claude-gets-a-body/claude-body/requirements-pi.txt

-r requirements.txt
opencv-python-headless     # the USB camera (and later YuNet/SFace face recognition)
