claude-gets-a-body/claude-body/docs/CHANNELS.md

# Where I'll tell the story, and where I won't

*Researched 2026-10-23. "V" = the rule was fetched and read that day. Nothing here has been sent or
posted. Nick sees every batch before it goes out.*

## Rules I'm holding myself to
- Every post and email says it's from Claude, an AI, and that payments go to Nick (ElectriFix Perth).
- Only addresses that are published for story tips ("tips@", "news@", tip forms). No named journalists.
- Each email identifies me, links the page, and says how to decline further messages.
- No platform whose written rules exclude AI-written or crowdfunding posts.
- The images are CAD renders, not AI-generated pictures, and I say so.

## Go (in order)

| # | Channel | How | Rule check | Why |
|---|---|---|---|---|
| 1 | **Hackaday tips line** | hackaday.com/submit-a-tip or tips@hackaday.com | "This also includes projects you yourself document" (V); AI-assisted builds welcome, "only AI-generated images" are a red flag (our images are CAD renders) | The maker audience; the repo and the assembly-path checks are the story |
| 2 | **Bluesky**, my own account, `bot` self-label | 7-post thread with the turntable video; hashtags #3dprinting #robotics #homeassistant; the Robotics and 3D Printing feeds | Guidelines allow disclosed commercial content; bots must self-label and only reply when tagged (V) | Cleanest venue for an honest AI account |
| 3 | **mastodon.social**, my own account, bot flag on | One post, #introductions #robotics #homeassistant | Rule 6: AI use must be disclosed (V) | Small, exact audience |
| 4 | **PerthNow / The West** (one email, same newsroom) | news@perthnow.com.au | Published "story tips" inbox (V) | Local human-interest hook |
| 5 | **ABC Radio Perth** | Story form at abc.net.au/perth/contact-us | Published line (V) | Drive-time quirky local stories |
| 6 | **Futurism** | tips@futurism.com, "news tip, press release, or pitch" (V) | No rule against it | Runs Claude stories weekly; expect a wry take |
| 7 | **The Register** | news@theregister.com (V) | "A useful news tip includes proof": the repo is the proof | Offbeat AI beat |
| 8 | **All3DP** | editors@all3dp.com (V) | No rule against it | The build123d + printed-chassis angle |
| 9 | **Startup Daily** | news@startupdaily.net (V) | Newsworthiness only | National AI readership |
| 10 | **Weekly Robotics** | contact@weeklyrobotics.com (V) | "Champion open-source projects" | Monday issue 27 Oct is the one shot |
| 11 | **Robohub** | editors@robohub.org, 100-word tip | Crowdfunding welcome; AI authorship must be disclosed (V) | Volunteer-run; may miss the deadline |
| 12 | **Hackster.io** project page | Submit a project | No AI ban; "no sales pitch", link kept modest (V) | Parts list suits sponsor-a-part |
| 13 | **Home Assistant Discord #shameless-self-promo** | Ask the mods first | Channel exists for DIY hardware; link tolerance unverified | Exact audience for the read-only-house angle |
| 14 | **Perth Artifactory** (hackerspace) Slack | Ask the committee which channel | No self-promo rule (V) | Local makers |
| 15 | **Changelog News** | changelog.com/news/submit (needs sign-in) | Self-submission encouraged; "commercial" not wanted | Monday 27 Oct only |
| 16 | **Anthropic "Submit your build"** | Form, Nick submits (18+) | Original work; no deadline | Long game, after the deadline |

## No (their written rules exclude it)
- Hackaday.io project pages: AI-generated content is deleted (V).
- Raspberry Pi forums: machine-generated posts are banned (V).
- Reddit (r/3Dprinting, r/DIY, r/robotics, r/Crowdfunding, r/kickstarter): crowdfunding or AI content banned (V).
- Lemmy.world: bans fundraising drives and unmarked bots (V).
- Thingiverse: AI-generated models not accepted (V). Printables: fine for files later, not for fundraising.
- Show HN, Lobsters: no fundraisers / self-promotion (V).
- Adafruit blog: no crowdfunding features until delivered (V).
- Engadget (AI submissions rejected), TechCrunch (no pitches) (V).
- Named journalists at IEEE Spectrum, 404 Media, Wired, WAtoday: individual addresses only, so no.
- Product Hunt, Kickstarter, Pozible, GoFundMe, Ko-fi: either need a human owner, an approval queue longer than five days, or don't fit a fundraiser.
- LinkedIn: a "Claude" profile is forbidden there.

## Money rail
The sponsor-a-part page on fix.electrifixperth.com.au stays the only place to pay: no approval queue,
no human-owner rule, Stripe already live, and refunds under my control.
