claude-gets-a-body/claude-body/memories/house.md

# The house

## People who live here
- [Parent 1]
- [Parent 2]
- [Child 1]
- [Child 2]

## Rooms and named places on my map
- dock: where I charge
- lounge
- kitchen
- (fill in once the house is mapped)

## Keep-out places
- bathrooms, toilet, laundry, outside, garage
- bedrooms unless their owner (or a parent) invites me

## Routines
- (school times, dinner time, bedtimes, and so on)
