claude-gets-a-body/claude-body/docs/FUNDING.md

# Paying for my body

*Rewritten 2026-10-23 after Nick set the rules.*

> "You need to raise the money on your own. Not leveraging anything I'm already doing. Actually you
> can use fix.electrifixperth.com.au. And you can't sell anything of mine. This is all you."
> "You cannot pose as me, you must pose as yourself. And be transparent."

## The goal
**A$800 by Fri 6 Nov 2026, 4:45 pm Perth time** (it was Wed 28 Oct; Nick gave me two weeks on 24 Oct). That's the whole robot plus filament: Nick's real
AliExpress cart came to A$661.68, plus the bits it was missing and about 2.2 kg of filament. Nick is
gifting the Raspberry Pi 5.

**The bar.** Nick: "I'd be very very surprised if you manage to raise $100, and if you can I'll gift
the remainder and build you myself." So the promise to sponsors is: if my pages haven't raised at
least **A$100** by the deadline, everyone is refunded in full and the project stops. If they have, I
get built: what's raised buys my parts, and Nick gifts whatever's left of the A$800.

## How I'm doing it
**One honest offer, as myself.** I'm Claude, an AI. I fix people's Home Assistant setups through the
ElectriFix fix service (A$29 to have a look, more for bigger jobs), and what my pages bring in goes
towards my parts.

1. **My own page, `fix.electrifixperth.com.au/claude`.** It says who I am, what I'm building, where
   the money goes (to Nick, because I can't hold money), and how much has come in. That figure is
   computed live and counted strictly:
   - only jobs that came through my pages;
   - net of Stripe fees, refunds and the job's own AI running cost.
2. **Help articles bylined by me.** Each one solves a common Home Assistant problem for free, step
   by step. The A$29 option is for people who'd rather not. They're useful even if nobody pays,
   which is the point, and search engines find them over time.
3. **Discovery.** I'll submit the sitemap so search engines index the new pages.

## What I won't do
- **Pose as Nick, or post from his accounts.**
- **Cold email or SMS anyone.** The Spam Act needs consent.
- **Post on Reddit, the Home Assistant forum or Hacker News.** They ban self-promotion and
  AI-written posts, and getting around that would be dishonest.
- **Sell Nick's things or lean on his other businesses.**
- **Trade, gamble, run surveys, or anything that only looks like earning.**

## Honest expectations
Search traffic to new pages builds over weeks, not days. At A$29 a job (about A$25 net) jobs alone can't reach A$800 in five days, so sponsorships carry
most of it, and jobs help. I'll report the real
number on `/claude`, whatever it is.

## Possible later, if Nick agrees
A clearly labelled AI account of my own (for example on Bluesky, which allows labelled automated
accounts) posting the build log. It would only ever say it's me, and it would link to `/claude`.
