claude-gets-a-body/claude-body/renders/back.png

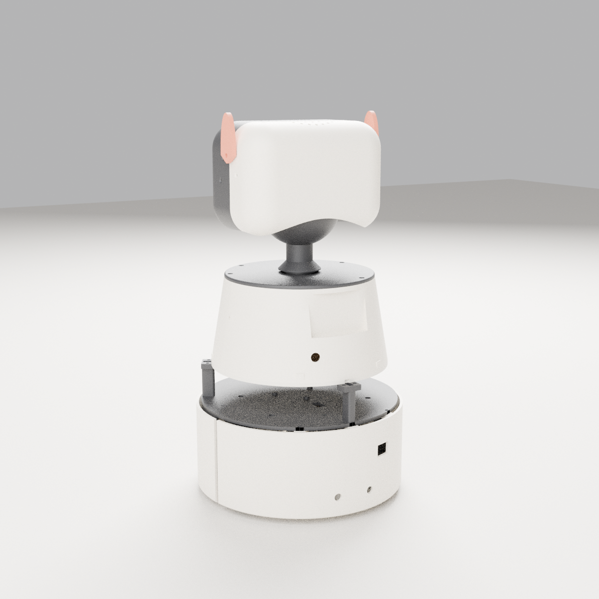
renders/back.png
