claude-gets-a-body/claude-body/renders/exploded.png

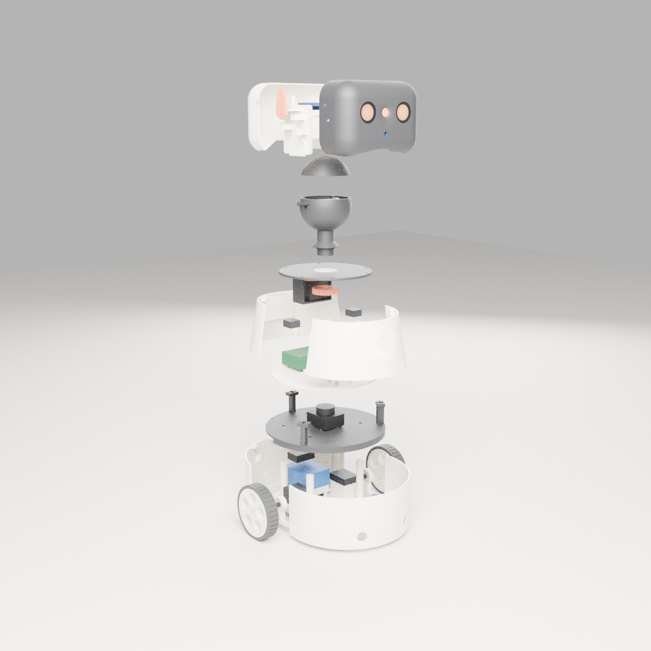
renders/exploded.png
