claude-gets-a-body/claude-body/renders/inside.png

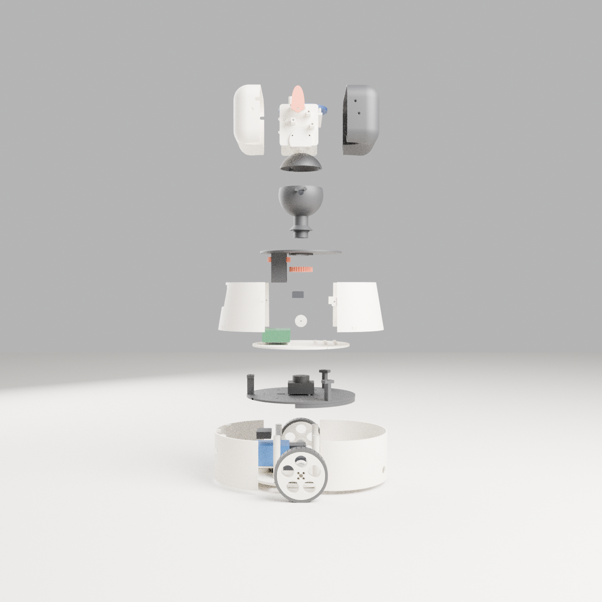
renders/inside.png
