claude-gets-a-body/claude-body/renders/side.png

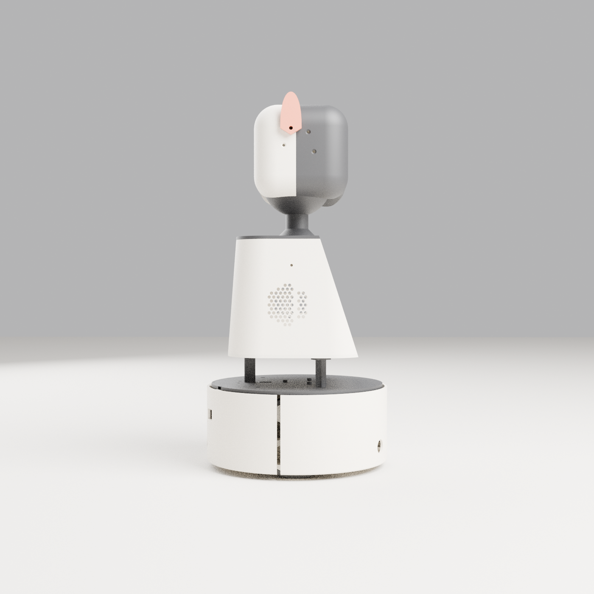
renders/side.png
