claude-gets-a-body/claude-body/sim_frames/dock.jpg

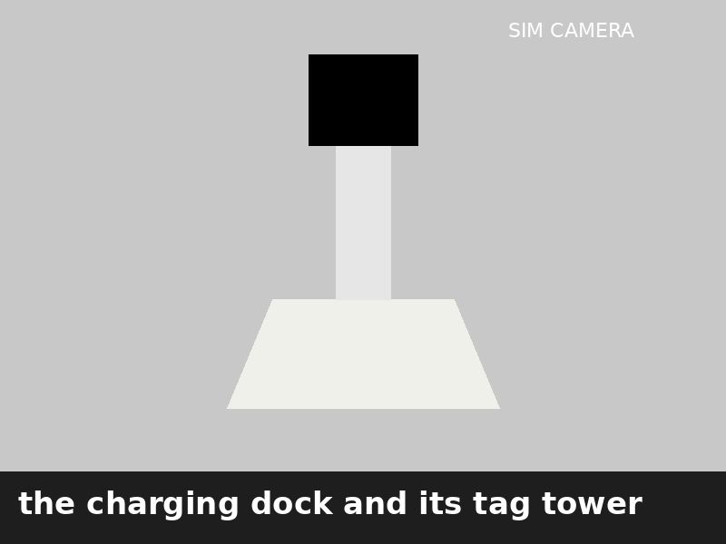
sim_frames/dock.jpg
