claude-gets-a-body/claude-body/sim_frames/homework.jpg

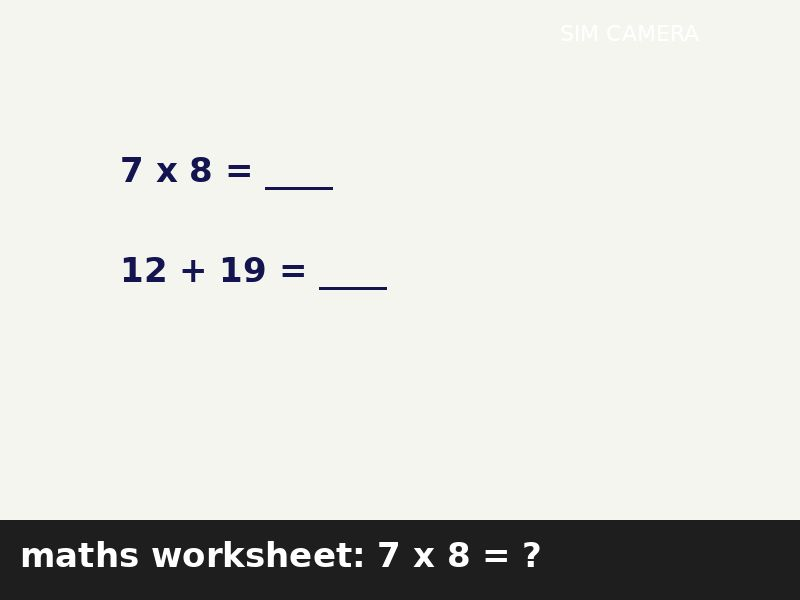
sim_frames/homework.jpg
