claude-gets-a-body/claude-body/sim_frames/kitchen.jpg

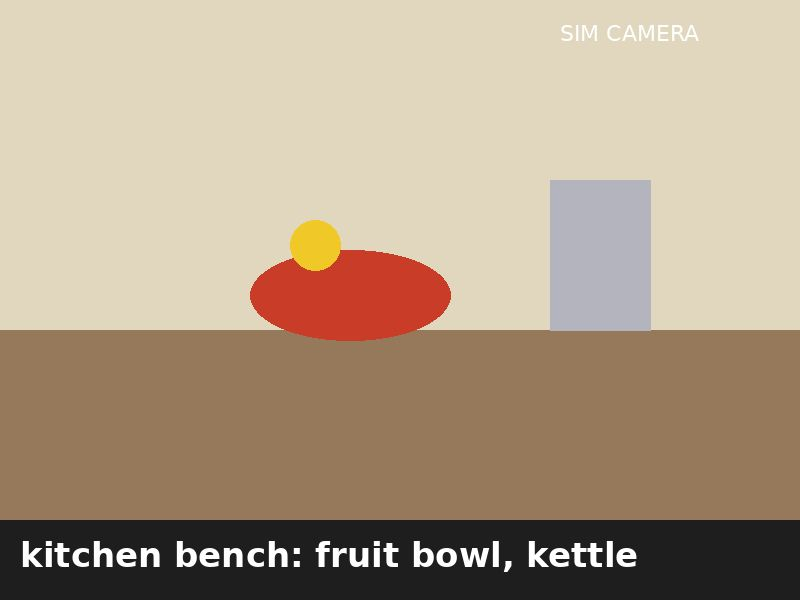
sim_frames/kitchen.jpg
