claude-gets-a-body/claude-body/sim_frames/lounge.jpg

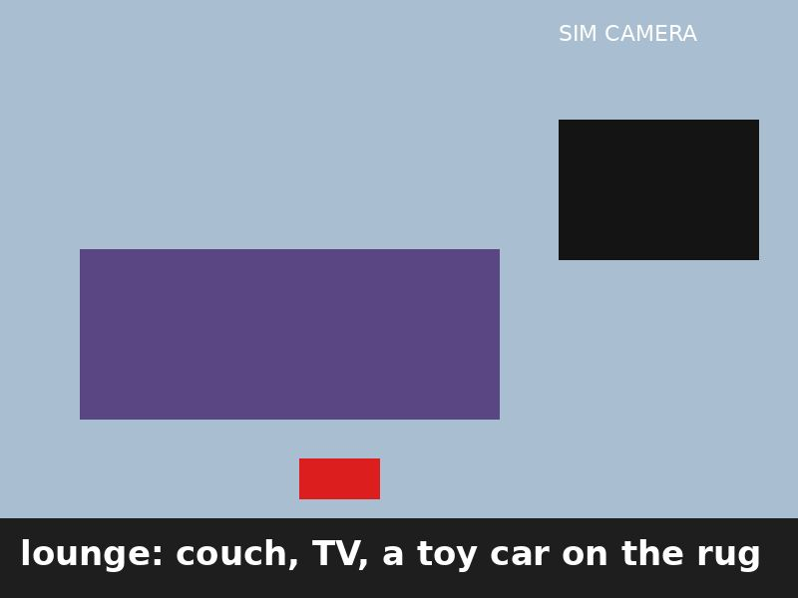
sim_frames/lounge.jpg
