claude-gets-a-body/claude-body/cad/out/print/body_back.stl

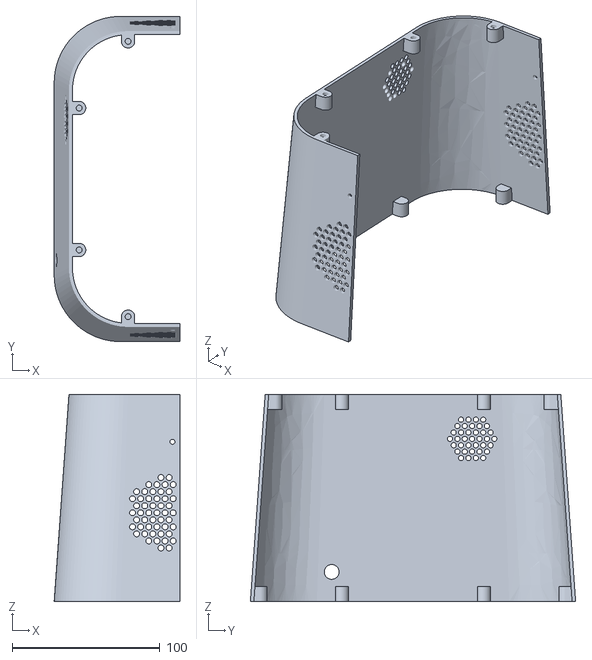
[picture p12: CAD file, 2026-10-29]
cad/out/print/body_back.stl
85.0 x 220.0 x 140.0
