claude-gets-a-body/claude-body/cad/out/print/eye_backplate_L.stl

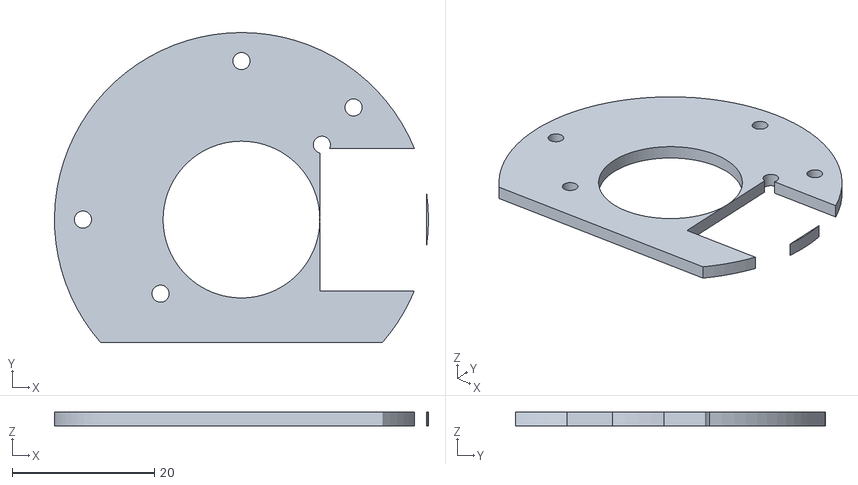
[picture p13: CAD file, 2026-10-29]
cad/out/print/eye_backplate_L.stl
52.5 x 43.5 x 2.00
