claude-gets-a-body/claude-body/cad/out/print/hub_drive.stl

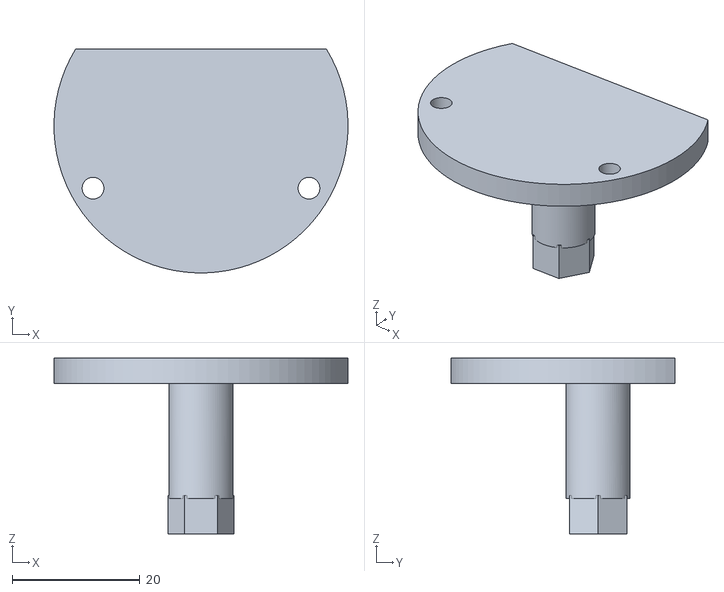
[picture p14: CAD file, 2026-10-29]
cad/out/print/hub_drive.stl
46.0 x 35.0 x 27.5
