claude-gets-a-body/claude-body/cad/out/print/head_front.stl

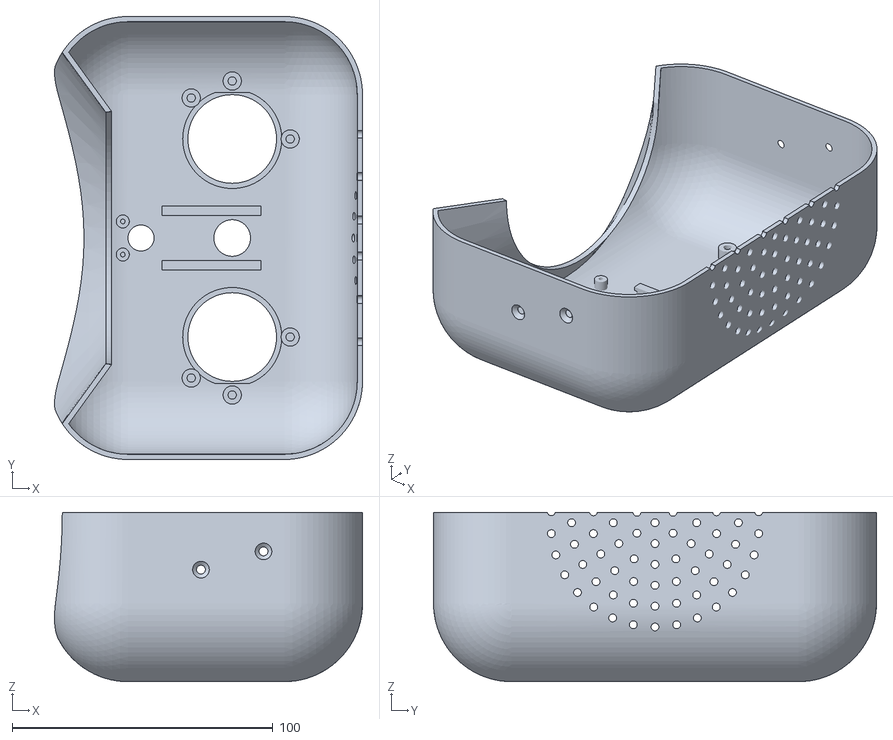
[picture p16: CAD file, 2026-10-29]
cad/out/print/head_front.stl
118.2 x 170.0 x 65.0
