claude-gets-a-body/claude-body/cad/out/print/screen_clamp.stl

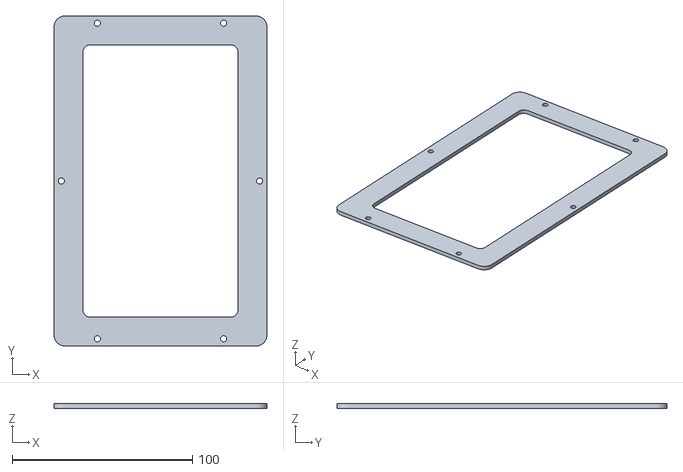
[picture p17: CAD file, 2026-10-29]
cad/out/print/screen_clamp.stl
118.0 x 183.0 x 2.50
