claude-gets-a-body/claude-body/cad/out/print/head_frame.stl

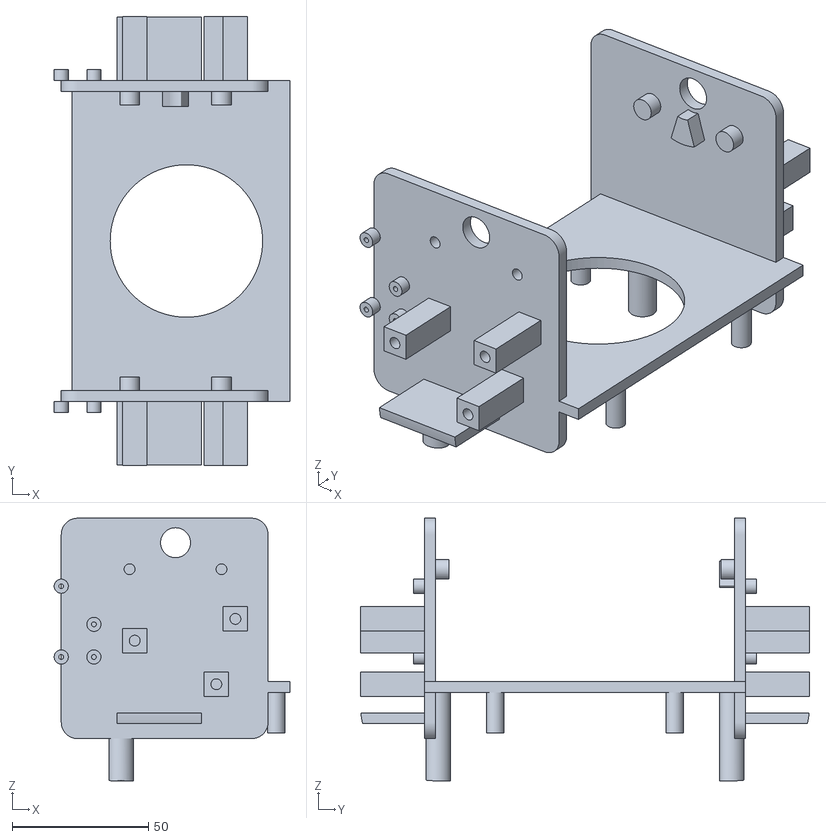
[picture p18: CAD file, 2026-10-29]
cad/out/print/head_frame.stl
86.6 x 165.0 x 96.5
