claude-gets-a-body/claude-body/cad/out/print/body_floor.stl

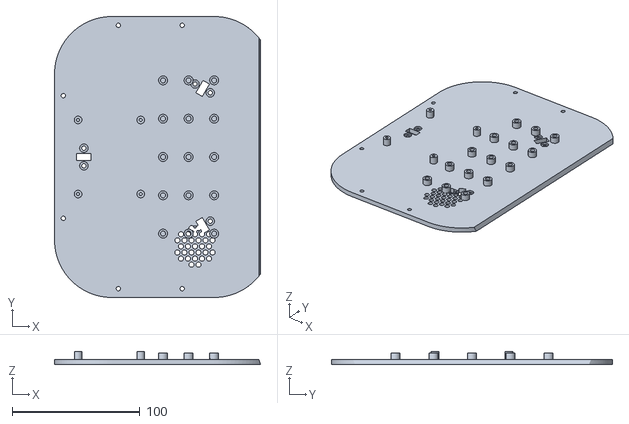
[picture p19: CAD file, 2026-10-29]
cad/out/print/body_floor.stl
161.3 x 220.0 x 10.0
