claude-gets-a-body/claude-body/cad/out/print/tilt_adapter.stl

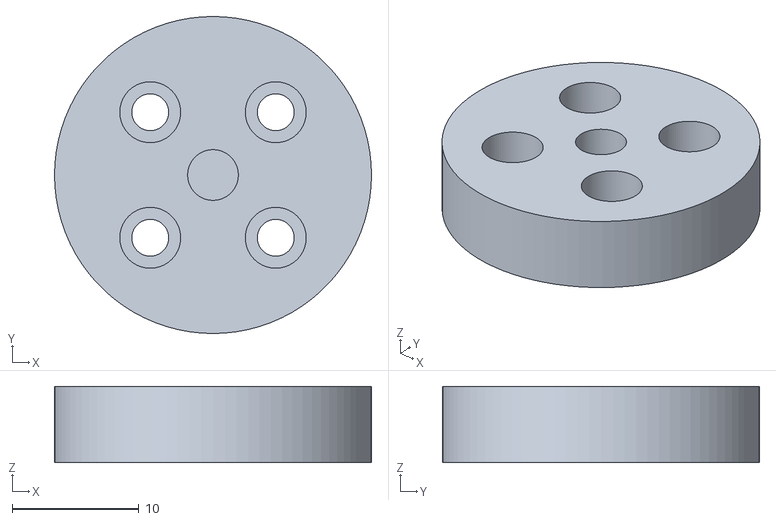
[picture p20: CAD file, 2026-10-29]
cad/out/print/tilt_adapter.stl
25.0 x 25.0 x 6.00
