claude-gets-a-body/claude-body/cad/out/print/tilt_coupler.stl

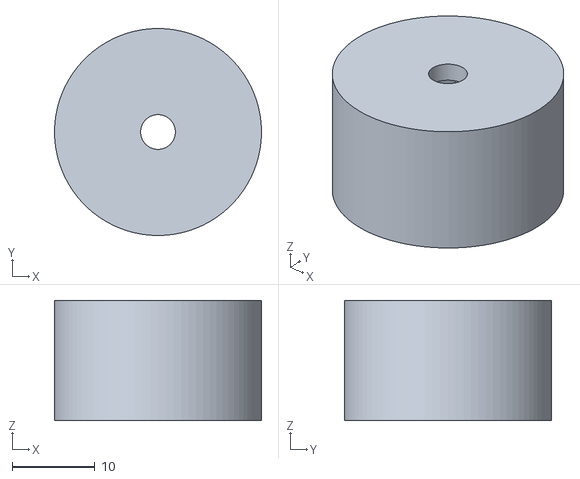
[picture p21: CAD file, 2026-10-29]
cad/out/print/tilt_coupler.stl
25.0 x 25.0 x 14.5
