claude-gets-a-body/claude-body/cad/out/print/shutter.stl

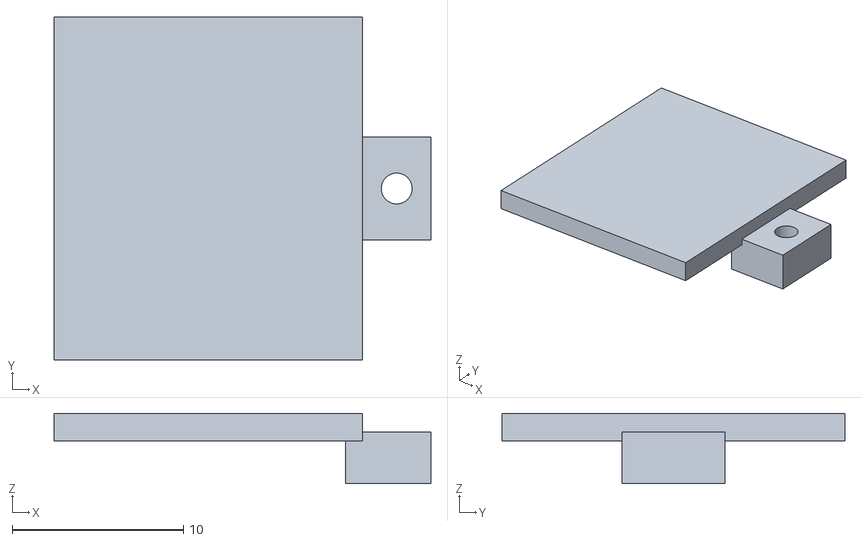
[picture p22: CAD file, 2026-10-29]
cad/out/print/shutter.stl
22.0 x 20.0 x 4.10
