claude-gets-a-body/claude-body/cad/out/print/waist_deck.stl

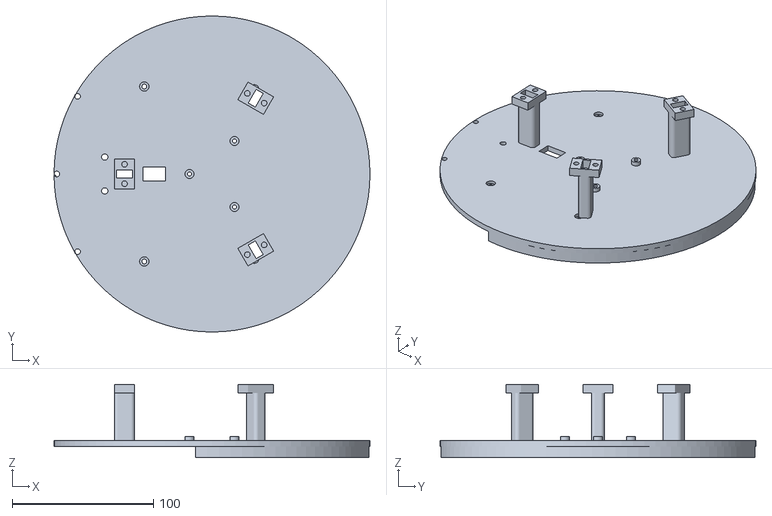
[picture p23: CAD file, 2026-10-29]
cad/out/print/waist_deck.stl
224.0 x 224.0 x 52.0
