claude-gets-a-body/claude-body/cad/out/print/pan_gear.stl

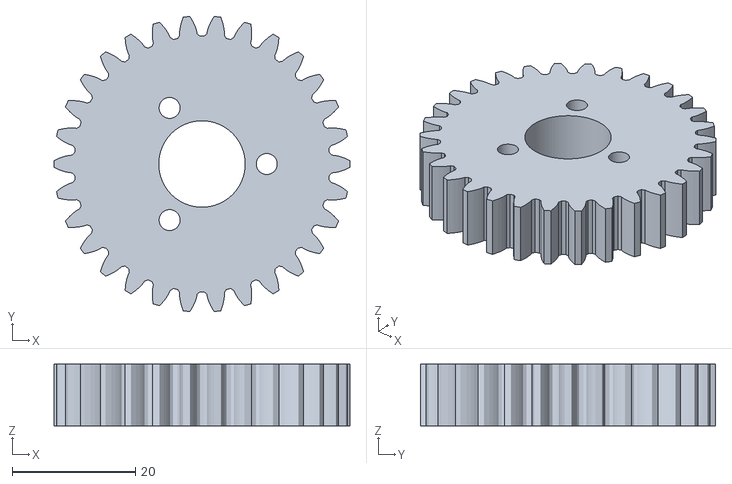
[picture p24: CAD file, 2026-10-29]
cad/out/print/pan_gear.stl
48.0 x 47.8 x 10.0
