claude-gets-a-body/claude-body/cad/out/print/ball_bowl.stl

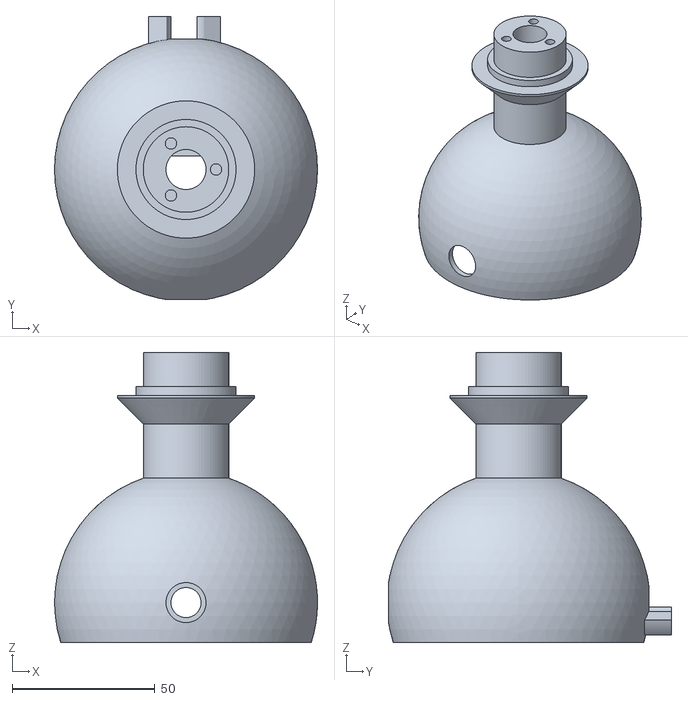
[picture p25: CAD file, 2026-10-29]
cad/out/print/ball_bowl.stl
92.0 x 99.0 x 101.5
