claude-gets-a-body/claude-body/cad/out/print/head_rear.stl

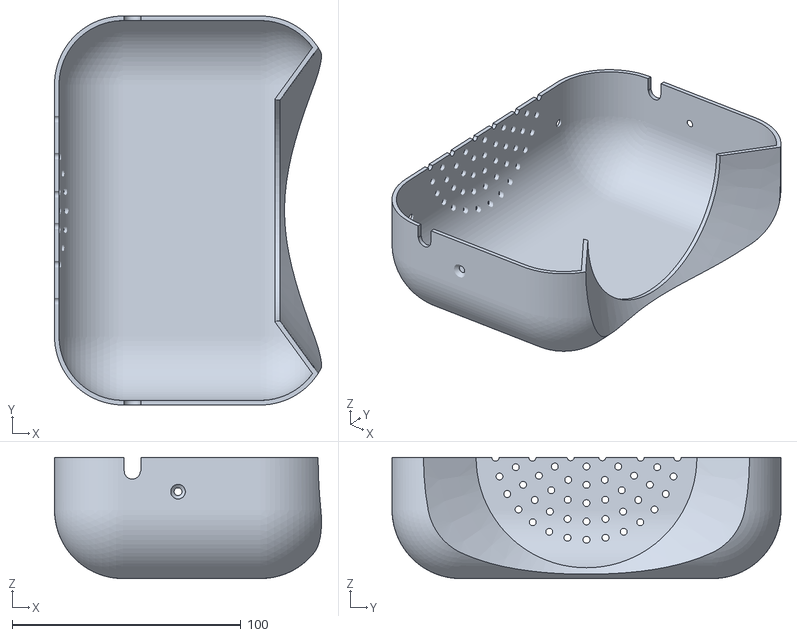
[picture p26: CAD file, 2026-10-29]
cad/out/print/head_rear.stl
116.7 x 170.0 x 53.0
