claude-gets-a-body/claude-body/cad/out/print/hub_idle.stl

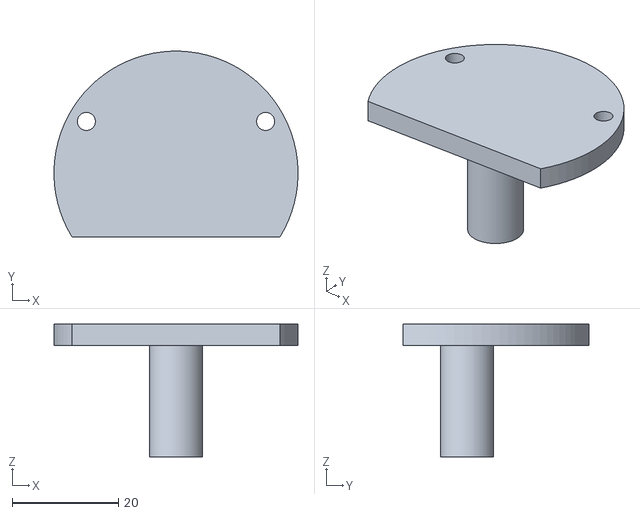
[picture p27: CAD file, 2026-10-29]
cad/out/print/hub_idle.stl
46.0 x 35.0 x 25.0
