claude-gets-a-body/claude-body/cad/out/print/clutch_hub.stl

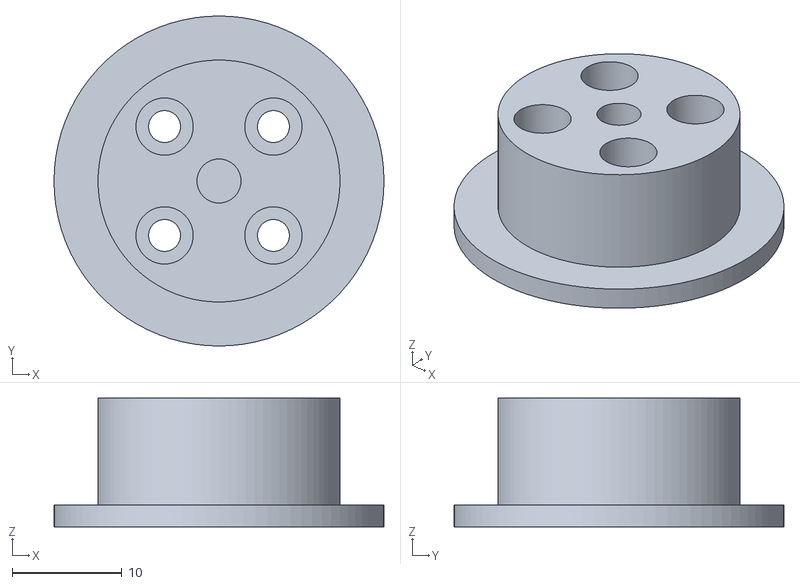
[picture p28: CAD file, 2026-10-29]
cad/out/print/clutch_hub.stl
30.0 x 30.0 x 11.7
