claude-gets-a-body/claude-body/cad/out/print/ball_cap.stl

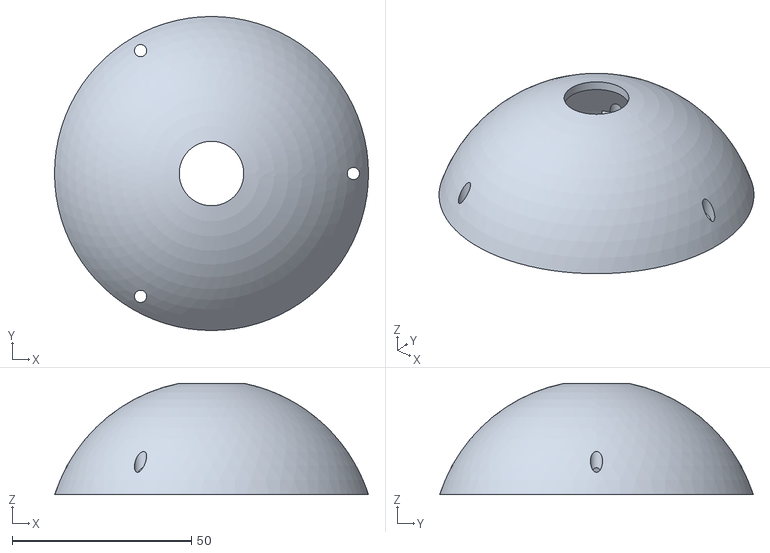
[picture p29: CAD file, 2026-10-29]
cad/out/print/ball_cap.stl
87.6 x 87.6 x 31.1
