claude-gets-a-body/claude-body/cad/out/print/body_lid.stl

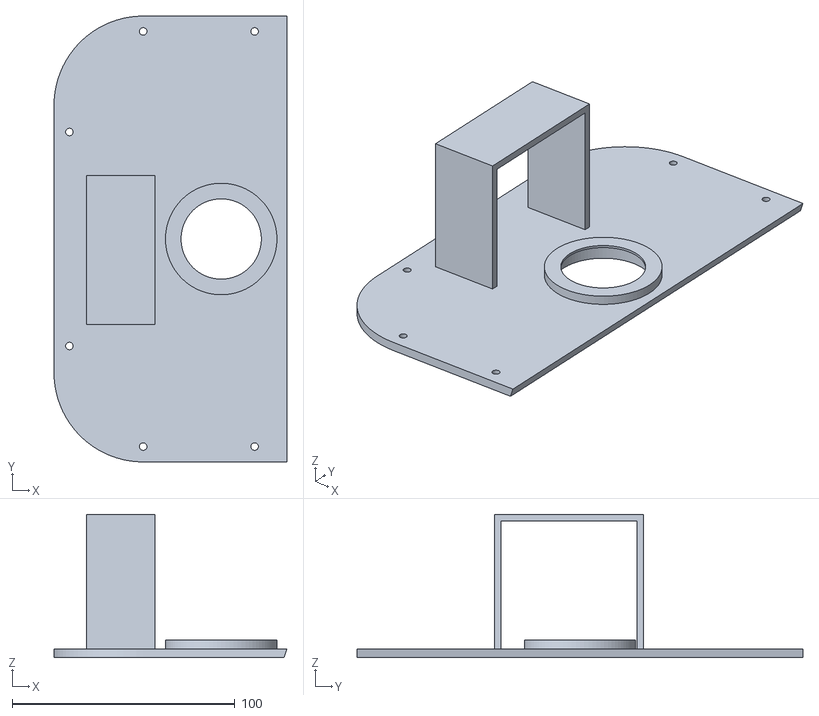
[picture p30: CAD file, 2026-10-29]
cad/out/print/body_lid.stl
104.5 x 200.0 x 64.3
