claude-gets-a-body/claude-body/cad/out/print/tyre_L.stl

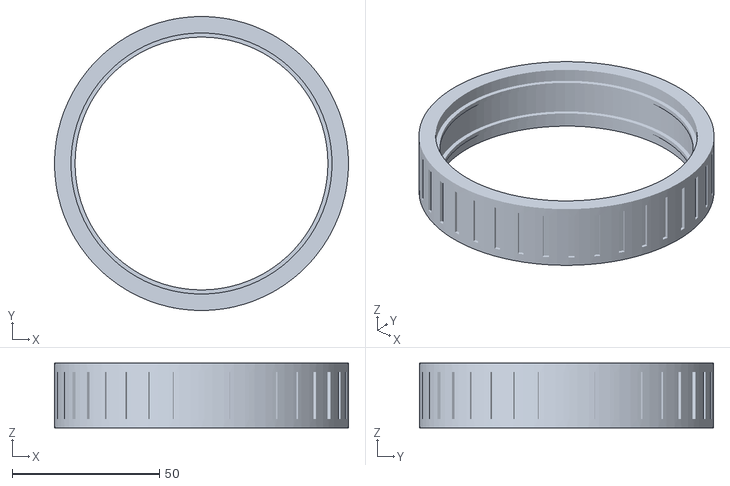
[picture p31: CAD file, 2026-10-23]
cad/out/print/tyre_L.stl
100.0 x 100.0 x 22.0
