claude-gets-a-body/claude-body/cad/out/print/dock_base.stl

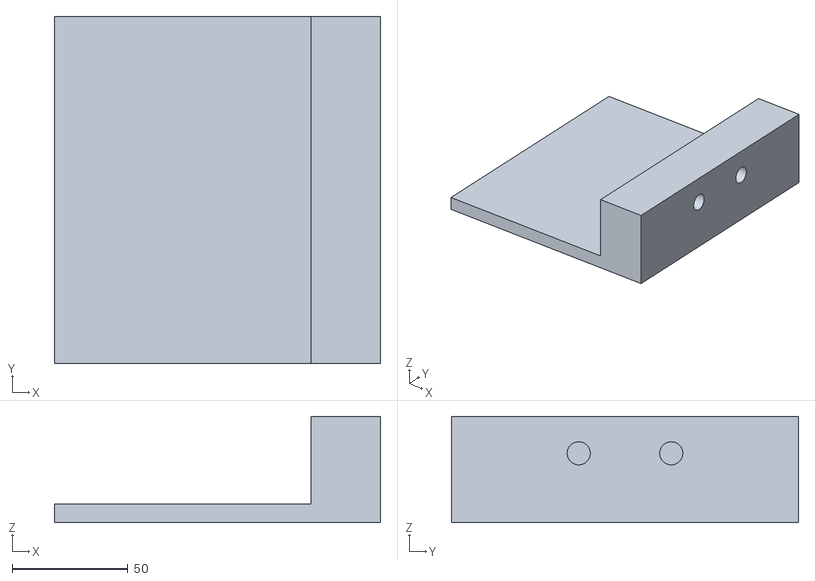
[picture p32: CAD file, 2026-10-23]
cad/out/print/dock_base.stl
141.0 x 150.0 x 46.0
