claude-gets-a-body/claude-body/cad/out/print/caster_retainer_F.stl

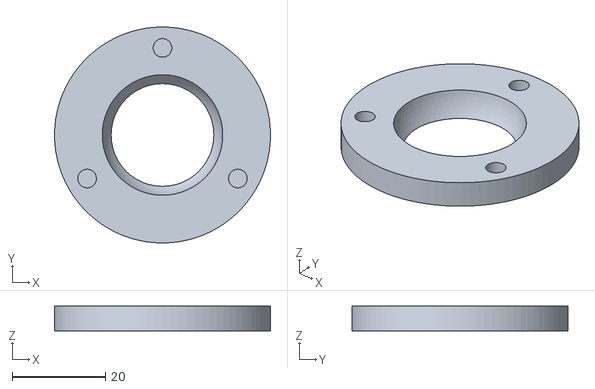
[picture p33: CAD file, 2026-10-23]
cad/out/print/caster_retainer_F.stl
46.4 x 46.4 x 5.28
