claude-gets-a-body/claude-body/cad/out/print/dock_tower_upper.stl

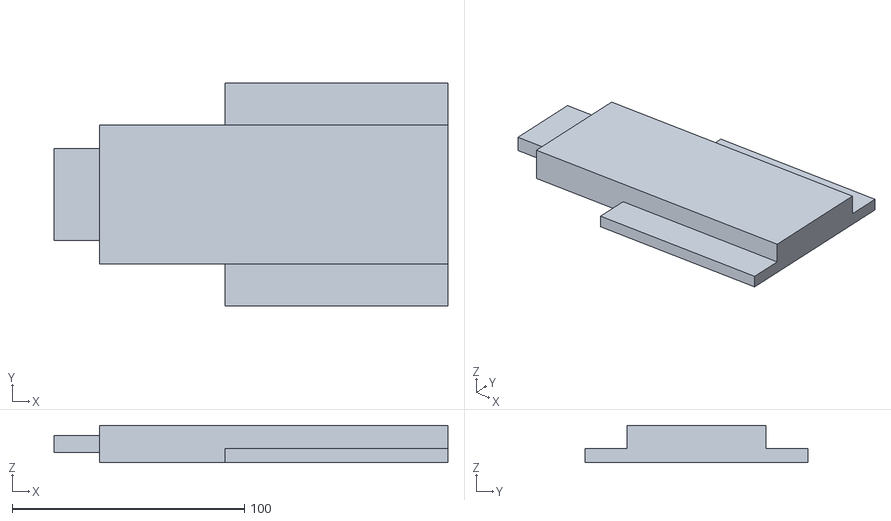
[picture p34: CAD file, 2026-10-23]
cad/out/print/dock_tower_upper.stl
169.5 x 96.0 x 16.0
