claude-gets-a-body/claude-body/cad/out/print/wheel_hub_L.stl

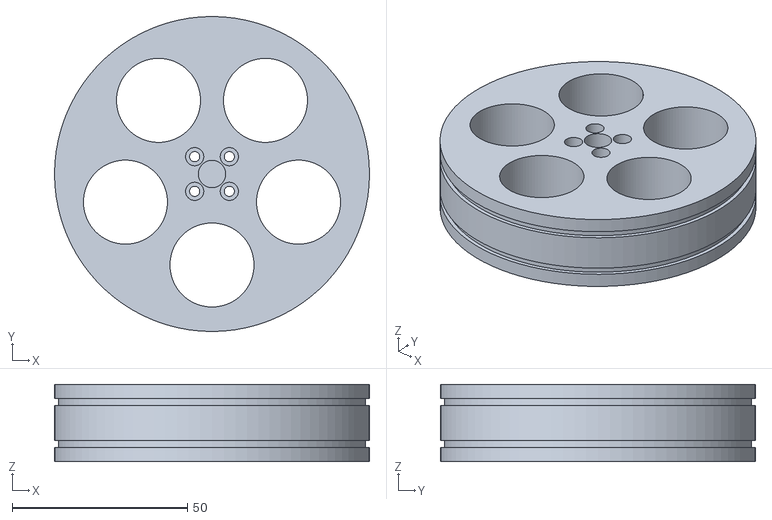
[picture p35: CAD file, 2026-10-23]
cad/out/print/wheel_hub_L.stl
90.0 x 90.0 x 22.0
