claude-gets-a-body/claude-body/cad/out/print/dock_tower_lower.stl

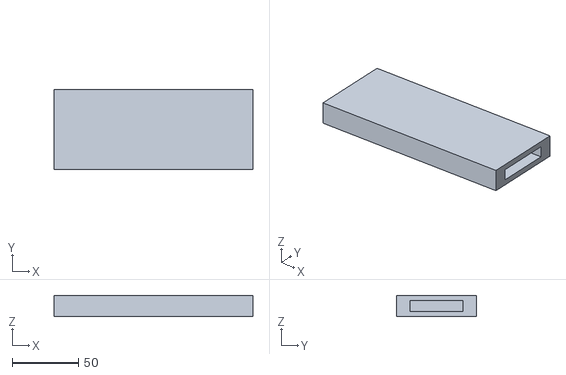
[picture p36: CAD file, 2026-10-23]
cad/out/print/dock_tower_lower.stl
150.0 x 60.0 x 16.0
