claude-gets-a-body/claude-body/cad/out/print/ear_R.stl

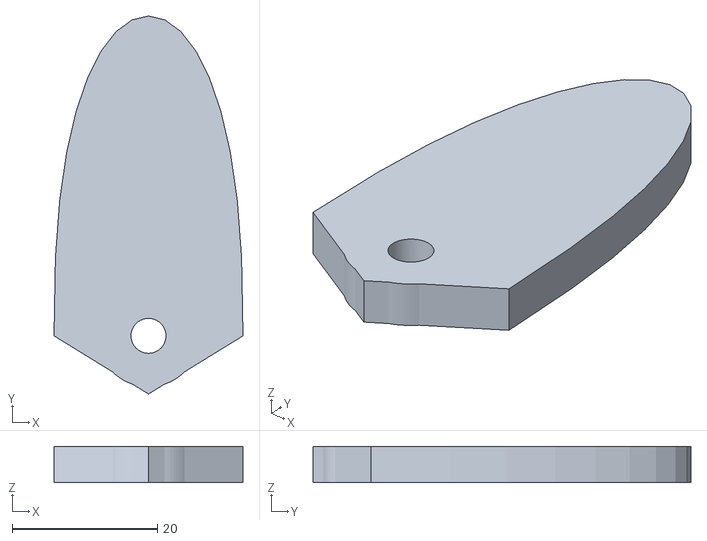
[picture p37: CAD file, 2026-10-23]
cad/out/print/ear_R.stl
26.0 x 52.0 x 5.00
