claude-gets-a-body/claude-body/cad/out/print/caster_housing_R.stl

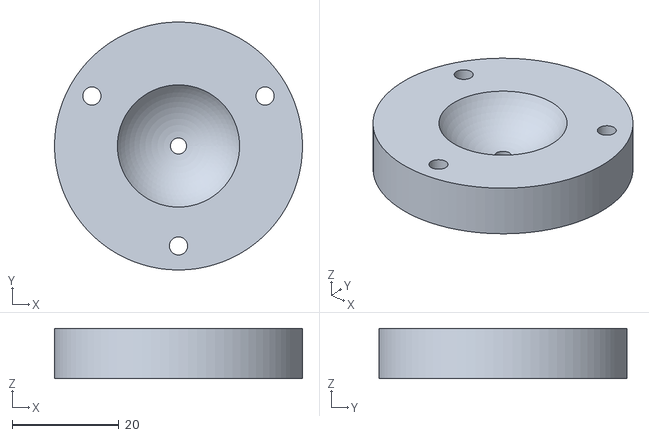
[picture p38: CAD file, 2026-10-23]
cad/out/print/caster_housing_R.stl
46.4 x 46.4 x 9.40
