claude-gets-a-body/claude-body/cad/out/print/clutch_cap.stl

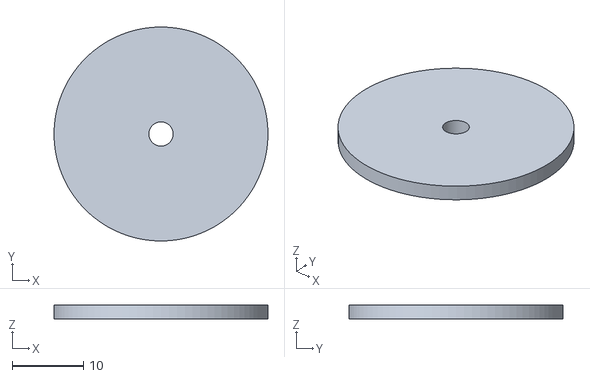
[picture p39: CAD file, 2026-10-23]
cad/out/print/clutch_cap.stl
30.0 x 30.0 x 2.00
