claude-gets-a-body/claude-body/cad/out/print/caster_retainer_R.stl

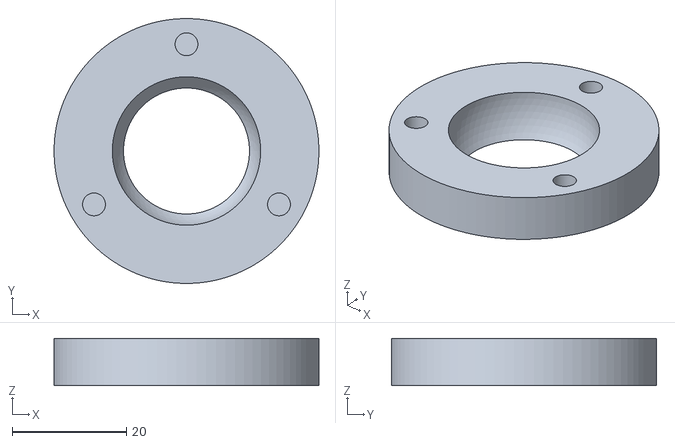
[picture p40: CAD file, 2026-10-23]
cad/out/print/caster_retainer_R.stl
46.4 x 46.4 x 8.28
