claude-gets-a-body/claude-body/cad/out/print/caster_housing_F.stl

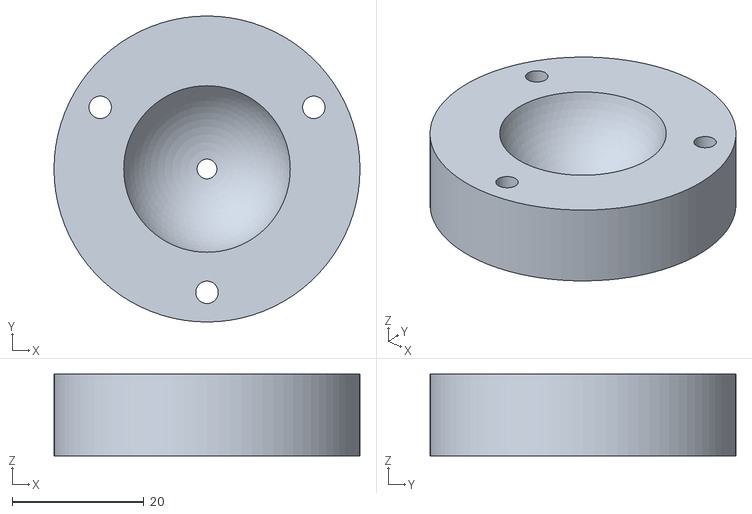
[picture p41: CAD file, 2026-10-23]
cad/out/print/caster_housing_F.stl
46.4 x 46.4 x 12.4
