claude-gets-a-body/claude-body/cad/out/print/bumper.stl

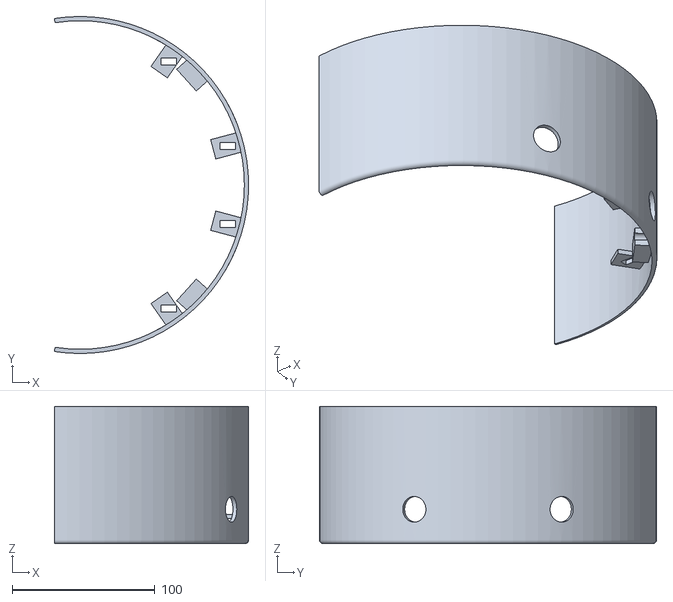
[picture p42: CAD file, 2026-10-23]
cad/out/print/bumper.stl
136.0 x 236.0 x 96.0
