claude-gets-a-body/claude-body/cad/out/print/skirt_rear.stl

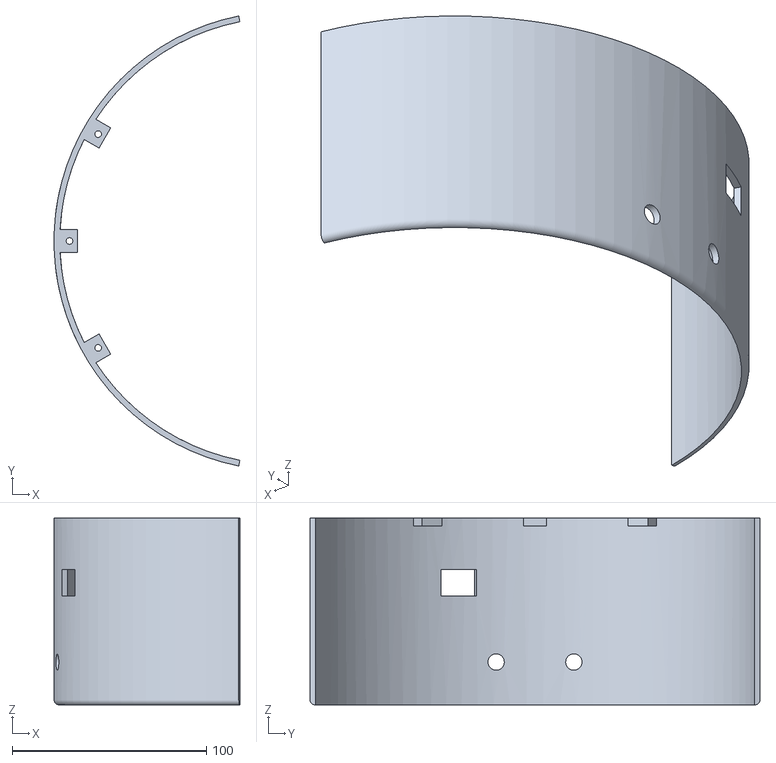
[picture p43: CAD file, 2026-10-23]
cad/out/print/skirt_rear.stl
95.6 x 231.5 x 96.0
