claude-gets-a-body/claude-body/cad/out/print/pinion_gear.stl

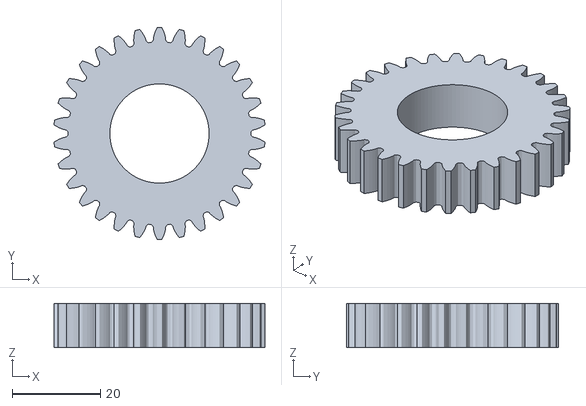
[picture p44: CAD file, 2026-10-23]
cad/out/print/pinion_gear.stl
47.8 x 48.0 x 10.0
