claude-gets-a-body/claude-body/cad/out/print/chassis_plate.stl

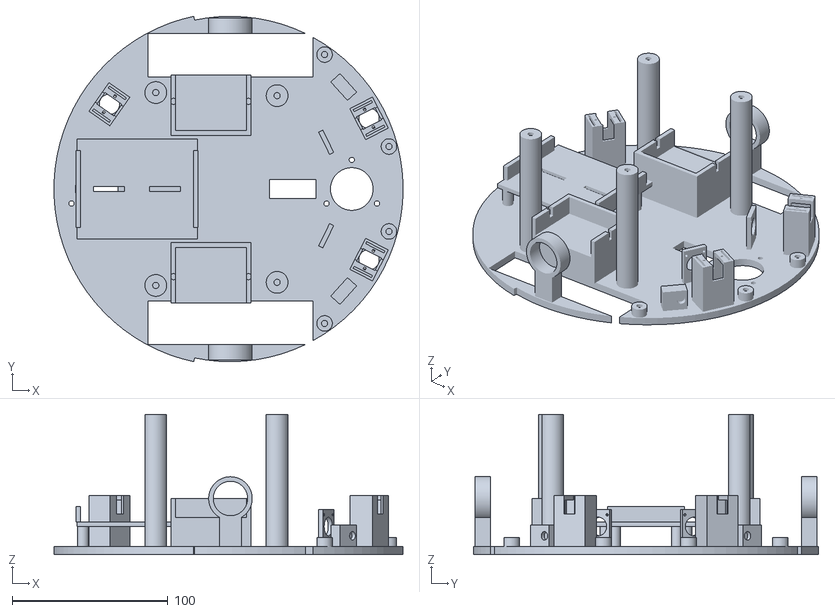
[picture p45: CAD file, 2026-10-23]
cad/out/print/chassis_plate.stl
224.3 x 222.0 x 90.0
