claude-gets-a-body/claude-body/(list of files, cad)

Other CAD files:
cad/out/print/eye_backplate_R.stl
cad/out/print/wheel_hub_R.stl
cad/out/print/ear_L.stl
cad/out/print/tyre_R.stl
