claude-gets-a-body/claude-body/cad/PRINT-LIST.md

# Print list

Generated by `build.py` from the model; don't edit by hand. Files are in `cad/out/print/`, already
laid flat in print orientation. Phase 1 = head on a stand (print first), 2 = legs, 3 = dock.
Settings: 0.2 mm layers, 3 walls, 15 % gyroid unless noted, textured PEI, M3 heat-set inserts at 220 °C.

| Phase | Part | Material | Size (mm) | ~g | How |
|---|---|---|---|---|---|
| 1 | `ball_bowl` | PETG charcoal | 92 × 99 × 102 | 74 | split face down, post up; tree supports inside the bowl |
| 1 | `ball_cap` | PLA charcoal | 88 × 88 × 31 | 22 | split face down |
| 1 | `body_back` | PLA cream | 85 × 220 × 140 | 123 | upright, no supports |
| 1 | `body_floor` | PETG | 161 × 220 × 10 | 121 | as exported |
| 1 | `body_front` | PLA cream | 85 × 220 × 140 | 84 | upright; tree supports under the screen window's top edge and the clamp bosses |
| 1 | `body_lid` | PETG | 104 × 200 × 64 | 85 | top face down; hanger plates point up |
| 1 | `clutch_cap` | PETG | 30 × 30 × 2 | 2 | as exported |
| 1 | `clutch_hub` | PETG | 30 × 30 × 12 | 4 | as exported |
| 1 | `ear_L` | TPU 95A (orange) | 26 × 52 × 5 | 4 | TPU, flat |
| 1 | `ear_R` | TPU 95A (orange) | 26 × 52 × 5 | 4 | TPU, flat |
| 1 | `eye_backplate_L` | PLA | 52 × 44 × 2 | 3 | as exported |
| 1 | `eye_backplate_R` | PLA | 52 × 44 × 2 | 3 | as exported |
| 1 | `head_frame` | PETG | 87 × 165 × 96 | 86 | bridge face down |
| 1 | `head_front` | PETG charcoal | 118 × 170 × 65 | 96 | front face down, so the face is smooth; tree supports inside only |
| 1 | `head_rear` | PLA cream | 117 × 170 × 53 | 83 | back face down; tree supports (touching buildplate) under the top fillet |
| 1 | `hub_drive` | PETG | 46 × 35 × 28 | 6 | as exported |
| 1 | `hub_idle` | PETG | 46 × 35 × 25 | 6 | as exported |
| 1 | `pan_gear` | PETG | 48 × 48 × 10 | 11 | as exported |
| 1 | `pinion_gear` | PETG | 48 × 48 × 10 | 10 | as exported |
| 1 | `screen_clamp` | PETG | 118 × 183 × 2 | 24 | flat |
| 1 | `shutter` | PLA orange | 22 × 20 × 4 | 1 | as exported |
| 1 | `tilt_adapter` | PETG | 25 × 25 × 6 | 2 | as exported |
| 1 | `tilt_coupler` | PETG | 25 × 25 × 14 | 5 | as exported |
| 2 | `bumper` | PETG cream | 136 × 236 × 96 | 117 | upright, no supports |
| 2 | `caster_housing_F` | PETG | 46 × 46 × 12 | 13 | as exported |
| 2 | `caster_housing_R` | PETG | 46 × 46 × 9 | 11 | as exported |
| 2 | `caster_retainer_F` | PETG | 46 × 46 × 5 | 6 | as exported |
| 2 | `caster_retainer_R` | PETG | 46 × 46 × 8 | 8 | as exported |
| 2 | `chassis_plate` | PETG | 224 × 222 × 90 | 272 | flat; standoffs and towers print upward, no supports |
| 2 | `skirt_rear` | PETG cream | 96 × 232 × 96 | 90 | upright, no supports |
| 2 | `tyre_L` | TPU 95A | 100 × 100 × 22 | 32 | TPU, slow (Elegoo TPU 95A @ECC profile), dry spool |
| 2 | `tyre_R` | TPU 95A | 100 × 100 × 22 | 32 | TPU, slow, dry spool |
| 2 | `waist_deck` | PETG | 224 × 224 × 52 | 155 | as exported |
| 2 | `wheel_hub_L` | PETG | 90 × 90 × 22 | 64 | inner face down |
| 2 | `wheel_hub_R` | PETG | 90 × 90 × 22 | 64 | inner face down |
| 3 | `dock_base` | PETG | 141 × 150 × 46 | 225 | as exported |
| 3 | `dock_tower_lower` | PETG | 150 × 60 × 16 | 93 | on its side |
| 3 | `dock_tower_upper` | PETG | 170 × 96 × 16 | 114 | tag face down |

Total ≈ 2.2 kg. Component brackets for the camera, boards and buck converter are deliberately NOT in this list. They get modelled after the real parts are measured.
