claude-gets-a-body/claude-body/memories/diary/README.md

# Diary

One page per day, `YYYY-MM-DD.md`, written by the nightly job.
