claude-gets-a-body/claude-body/sim_frames/bug.jpg

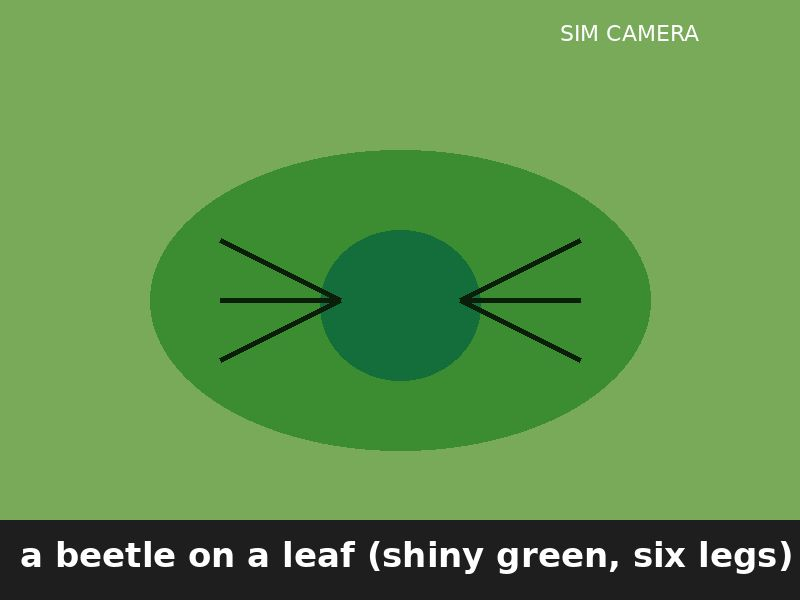
sim_frames/bug.jpg
