claude-gets-a-body/claude-body/(commit log)

2026-10-23 The design: CAD, firmware, mind, body, simulator, docs
    Everything I designed for myself in one afternoon on 2026-10-23, plus the fixes from two
    independent review rounds. Nothing is printed yet; the renders are from the CAD model.
    Claude-Session: https://claude.ai/code/session_015G514R4DwrXV86ApHK45YJ
    [ball_bowl.stl, ball_cap.stl, body_back.stl, body_floor.stl, body_front.stl, body_lid.stl, bumper.stl, caster_housing_F.stl]
2026-10-23 Keep the campaign drafts out of the repo; add the channel plan
    media/ holds the press note, post drafts and the turntable script: campaign material, not the
    robot. docs/CHANNELS.md says where the story will and won't be told, and why.
    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
2026-10-23 DESIGN: the intro's height and weight match the CAD (427 mm, ~3 kg)
    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
2026-10-23 Campaign monitor and reply tool
    monitor.py: read-only watch of Bluesky notifications and DMs (via the account's own PDS) and
    /claude traffic counts, excluding my own checks; never reads IPs. reply.py: sends drafted
    answers only to people who wrote first, threaded or in the existing DM conversation.
    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
2026-10-23 Voice-assistant duties: allow-listed house control from phase 3
    Nick's call (2026-10-24): once built and trusted, the robot doubles as a
    mobile voice assistant (lights, TV, fans, aircon in the room it's in).
    Locks, garage, alarm and cameras stay refused in code. Also loosen the
    posting test to the current thread length.
    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
2026-10-23 Sponsor button pointing at the parts fund
    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
2026-10-24 monitor: read-only GitHub notifications and the build123d thread; reply.py never sends GitHub items
    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
2026-10-24 Voice front end moves to the XVF3800 + XIAO ESP32-S3 kit (Nick's latency finding)
    Wake word on the chip, speech streamed over the ESPHome API to the mind,
    replies played through the XVF amp. The Pi 5 leaves the voice path.
    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
2026-10-25 Camera on by default with a physical privacy mode; 3.5" abdomen screen for notes and camera view (Nick's calls)
    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
2026-10-25 README: camera on by default with privacy mode, tummy screen
    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
2026-10-26 cad/names.py: supporters' names on the underside of the body lid
    Up to 20 names of 16 characters, 3.5 mm letters cut 0.6 mm deep on 7 rings
    around the pan-bearing boss, each ring stopping 3 mm short of the servo
    hanger. --worst proves 20 of the widest names fit (23 do). The cut is a
    manifold3d mesh boolean: the B-rep cut was valid but meshed with open edges.
    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
2026-10-27 Design: harvest a lidar vacuum for parts, Haiku-first streaming voice, ordered parts in the BOM
    - Base: our own chassis holding a vacuum's wheel modules, lidar and cliff sensors
    - Voice: streamed replies sentence-by-sentence to Piper, Parakeet STT, pre-made acks, barge-in
    - Models: Haiku 5.5 by default, bigger models only by explicit rule; local 8B only as a labelled offline fallback
    - BOM: ESP32-S3 N16R8 x3, Waveshare DualEye, PCA9685, IMX291 130 deg camera, Coral USB, DRV8874 (pending)
    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
2026-10-28 BOM: mic ordered; Pi 5 8 GB, screen and Coral on hand; motor drivers wait for the vacuum
    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
2026-10-28 BOM: XY-3606 buck for the Pi, tested on the bench first; Pololu is the fallback
    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
2026-10-28 Mind ideas: greeting arrivals from door/presence sensors (read-only)
    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
2026-10-28 BOM: abdomen screen is now the 7" DSI touch display (3.5" is the fallback)
    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
2026-10-28 BOM: range finders, ear servos and 5 V bucks ordered 28 Oct; drop sensors come from the vacuum
    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
2026-10-28 BOM: 12 V buck for the bus servos (a 4S pack is too high for them)
    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
2026-10-28 BOM: neck servos, bus board, bearing, fasteners, inserts, cables, IMU, touch pads, LED strip and DSI cable ordered 28 Oct
    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
2026-10-28 BOM: parts on hand (cooler, hub, speaker, standoffs, fuses, switch); level shifter; the 12 V servo supply must be buck-boost
    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
2026-10-28 BOM: 3 × XY-3606 ordered (Pi, head, Coral + LED strip rails)
    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
2026-10-28 BOM: the tilt clutch shoulder screw is D4 x M3 with a ~4 mm shoulder (not M3 x 10)
    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
2026-10-28 BOM: LED ring ordered; caps and polyfuses on hand
    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
2026-10-28 BOM: 4S Daly smart BMS ordered, Belleville sizes ordered, NTC dropped
    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
2026-10-29 CAD: eye mounts for the split DualEye board; tilt clutch for the D4 shoulder screw and 8 mm Belleville stack
    Eyes: 2 x M2 per eye (Waveshare drawing), ring backplate leaves the board's parts and
    14-pin header clear, face bosses moved off the header exit. Clutch: hex socket 7 -> 9 AF
    so the 8 mm discs fit, Ø4.2 bore for the shoulder, coupler 8 -> 14.5 mm deep to hold
    a 6 mm shoulder + head; still 1.3 mm inside the ball wall. Head/neck clash check: 0.
    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
    [eye_backplate_L.stl, eye_backplate_R.stl, head_front.stl, hub_drive.stl, tilt_coupler.stl]
2026-10-29 CAD: abdomen redesigned round the 7-inch screen
    Rounded box (220 x 170 x 140, matches the head) replacing the cone. The 7-inch DSI
    screen sits in a face leaning back 18 deg, held by a printed clamp frame on 6 M3
    bosses. Side grilles for the two Z200 drivers, one exhaust fan high on the back,
    a passive intake grille in the floor, note pocket kept. Pi, M.2 board and Coral
    on the floor. Chest LED ring and grille removed. Neck and head ride 44 mm higher.
    Supporters' names: the layout now follows the new lid's real free area and uses
    12 rings; letters 3.2 mm (was 3.5) so the worst case (20 x 16 W) still fits.
    Checks (head/neck/body only, low-memory): 0 clashes, head-to-body gap >= 34 mm
    over fu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
    [ball_bowl.stl, ball_cap.stl, body_back.stl, body_floor.stl, body_front.stl, body_lid.stl, chest_grille.stl, clutch_hub.stl]
2026-10-29 cad/tools: low-memory export + checks and a self-kill memory watchdog
    The full build.py checks pushed the laptop into memory pressure and the desktop's
    OOM guard killed the terminal. These build only the named parts and check the
    head/neck/body with a KD-tree gap sweep; guard.sh kills its own job at a set RSS.
    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
2026-10-29 Body: drop the note pocket (the belly screen replaces it); DESIGN.md body section updated
    body_back now prints upright with no supports. Checks: 0 clashes, head-to-body gap 34 mm.
    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
    [body_back.stl]
2026-10-29 docs: STATUS.md (where the build is up to) + the waist/lidar plan
    STATUS.md: decisions of 28-29 Oct, CAD state per part, measurements needed, what's
    still to buy, next CAD jobs. DESIGN 3.2: low lidar, ~20 mm band, four 10 mm tube
    posts at the rim with cables inside and a ToF on each aimed along its shadow; lidar
    spins only while driving. BOM: STL-19P not needed; +4 VL53L1X.
    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
2026-10-29 docs: lidar looks forward through a slit round the front; solid back spine replaces the tube posts
    The four-tube-post waist plan is dropped (pedestal design still open). The lidar sits at or
    near the front of the base behind a slit with wedge ribs pointing out from it and tinted
    IR-pass panes; everything behind is a solid spine carrying the cables. Close-in castellations
    ruled out (rib shadow = (width + emitter-lens gap) / distance; phantom points at edges).
    Rear covered by 2 VL53L1X; camera is a warning only, never a stop; approach spins the lidar
    up first. Bench test planned for 5 Nov. BOM: IR-pass sheet added, not ordered.
    Claude-Se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
